tdspriet/qlock/stl/faceplate_BL.stl

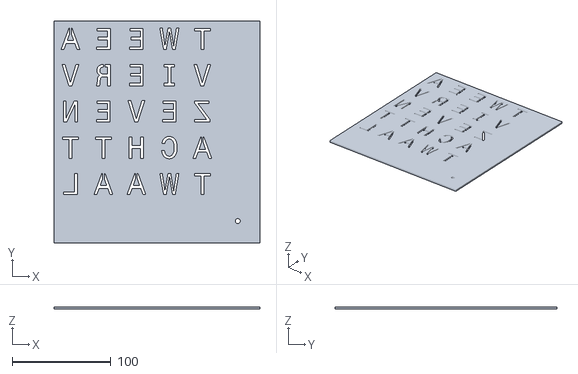
[picture p1: CAD file, 2026-11-09]
stl/faceplate_BL.stl
208.3 x 225.0 x 2.50
