tdspriet/qlock/stl/lightgrid_TR.stl

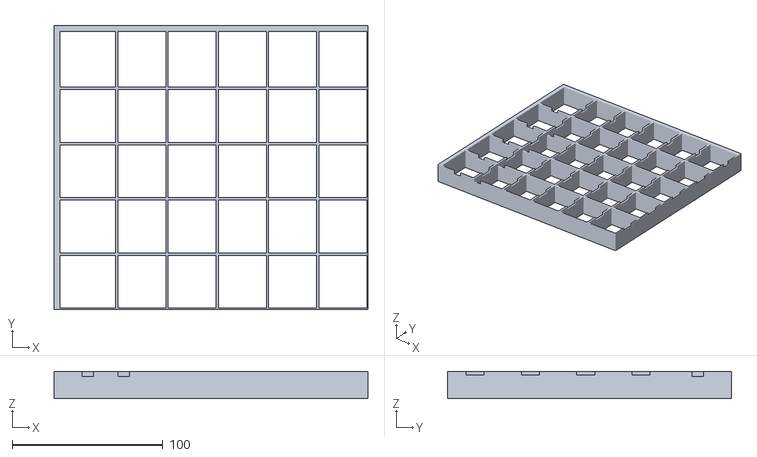
[picture p2: CAD file, 2026-11-09]
stl/lightgrid_TR.stl
208.3 x 188.3 x 18.0
