tdspriet/qlock/stl/faceplate_TR_letters.stl

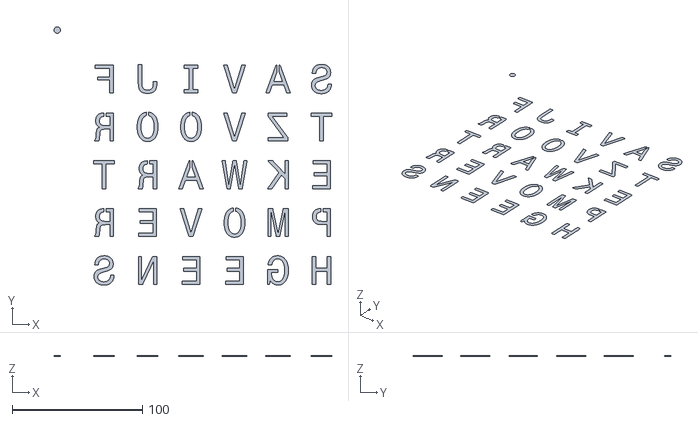
[picture p3: CAD file, 2026-11-09]
stl/faceplate_TR_letters.stl
213.1 x 198.1 x 0.4
