tdspriet/qlock/stl/faceplate_BR.stl

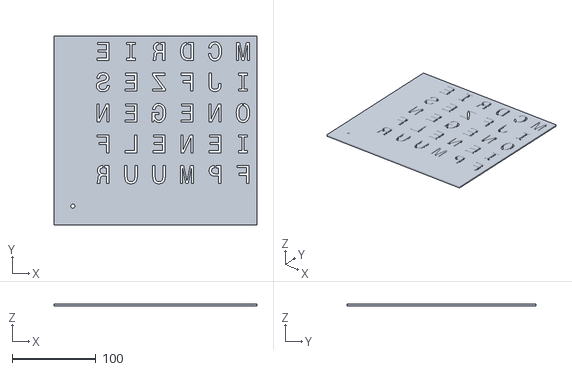
[picture p4: CAD file, 2026-11-09]
stl/faceplate_BR.stl
241.7 x 225.0 x 2.50
