tdspriet/qlock/stl/sample_faceplate_letters.stl

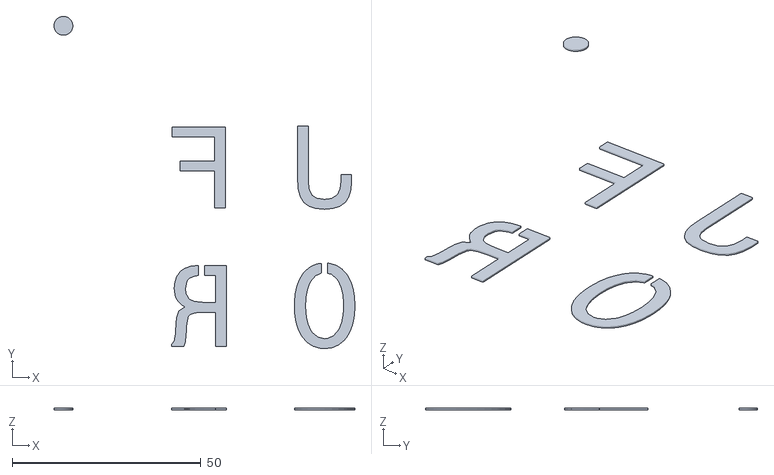
[picture p5: CAD file, 2026-11-09]
stl/sample_faceplate_letters.stl
79.8 x 88.1 x 0.4
