tdspriet/qlock/stl/lightgrid_BL.stl

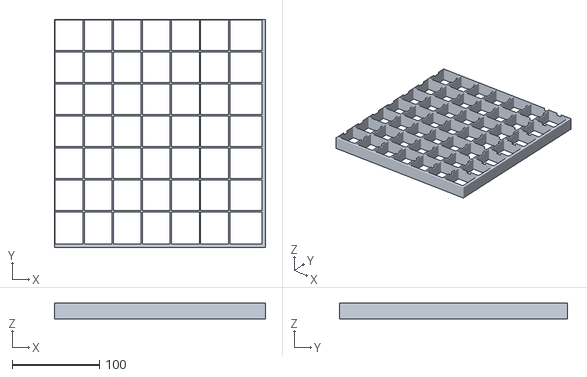
[picture p6: CAD file, 2026-11-09]
stl/lightgrid_BL.stl
241.7 x 261.7 x 18.0
