tdspriet/qlock/stl/lightgrid_TL.stl

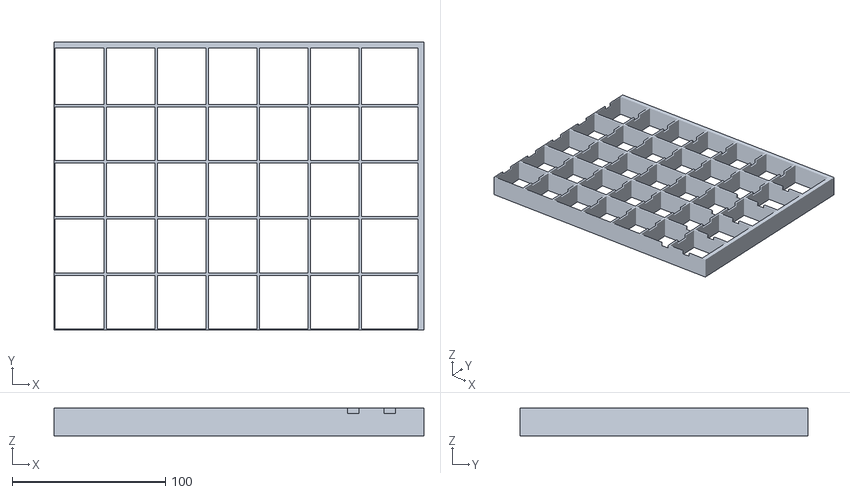
[picture p7: CAD file, 2026-11-09]
stl/lightgrid_TL.stl
241.7 x 188.3 x 18.0
