tdspriet/qlock/stl/faceplate_BL_letters.stl

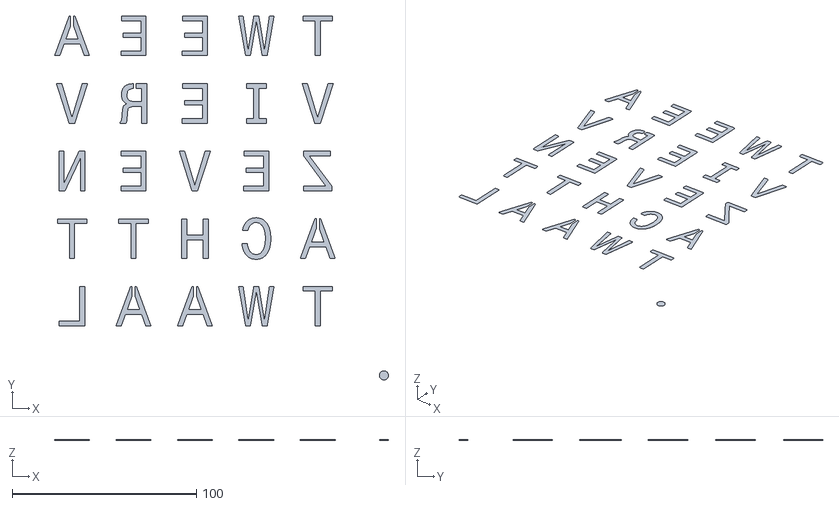
[picture p8: CAD file, 2026-11-09]
stl/faceplate_BL_letters.stl
181.3 x 197.5 x 0.4
