tdspriet/qlock/stl/faceplate_TL_letters.stl

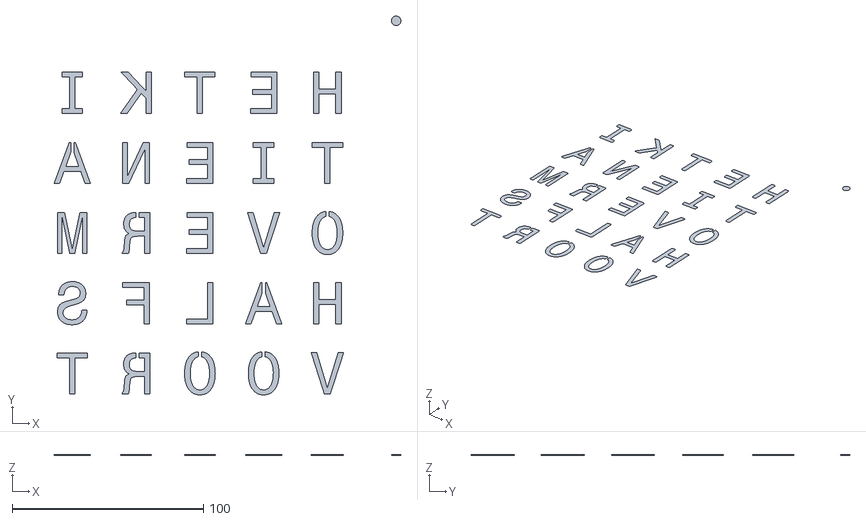
[picture p9: CAD file, 2026-11-09]
stl/faceplate_TL_letters.stl
181.3 x 198.0 x 0.4
