tdspriet/qlock/stl/sample_faceplate.stl

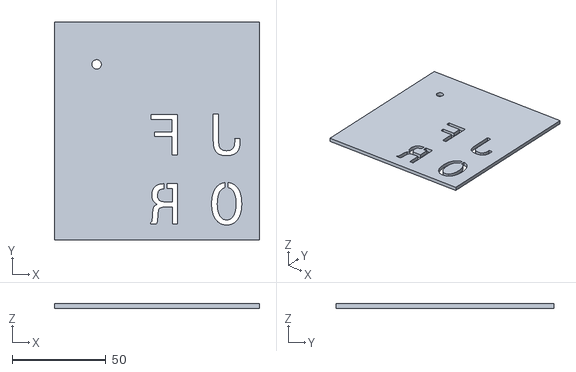
[picture p10: CAD file, 2026-11-09]
stl/sample_faceplate.stl
109.1 x 115.8 x 2.50
