tdspriet/qlock/stl/sample_lightgrid.stl

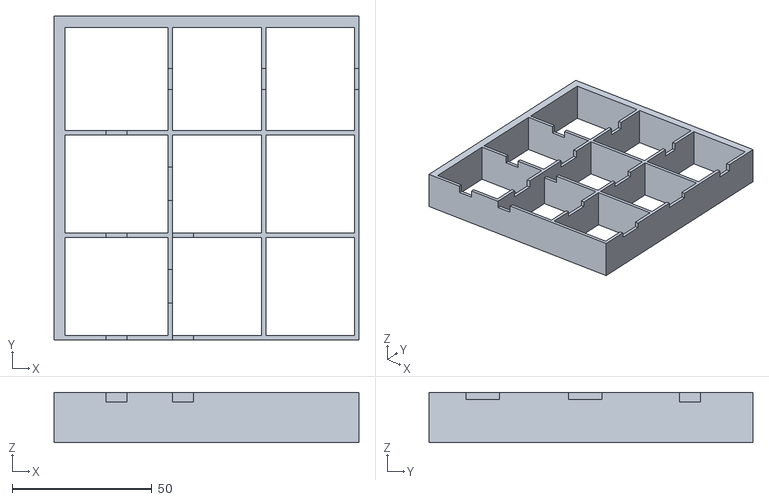
[picture p11: CAD file, 2026-11-09]
stl/sample_lightgrid.stl
109.1 x 115.8 x 18.0
