tdspriet/qlock/stl/lightgrid_BR.stl

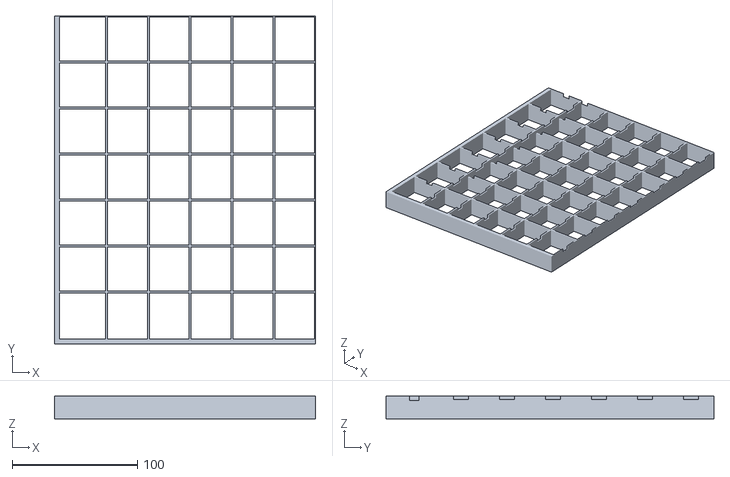
[picture p12: CAD file, 2026-11-09]
stl/lightgrid_BR.stl
208.3 x 261.7 x 18.0
