tdspriet/qlock/(list of files, cad)

Other CAD files:
stl/faceplate_TL.stl
stl/faceplate_TR.stl
stl/faceplate_BR_letters.stl
