tdspriet/qlock/(commit log)

2026-10-25 QLOCK: STLs, firmware, tools and build tracker
    [faceplate_BL.stl, faceplate_BR.stl, faceplate_TL.stl, faceplate_TR.stl, faceplate_sample.stl, lightgrid_BL.stl, lightgrid_BR.stl, lightgrid_TL.stl]
2026-10-25 Simplify the build tracker
    Cut what isn't needed day to day: stats header, up-next box, layer
    labels, camera presets, shop filters, paid field, build log and the
    rules tab. Calmer styling with one typeface and no stencil headings.
    Part card shows only the clicked part; light-up restores the exploded
    view; LED colour is the firmware's warm white in both themes.
    Claude-Session: https://claude.ai/code/session_01A9cgHg2mFhKhLrvVkcM7Kx
2026-11-09 Back to 45 × 45 cm, printed on the Bambu Lab H2C
    The 376 mm plate only existed to fit four tiles on the Ultimaker's 215 mm
    bed. On the H2C (325 × 320) the full 450 mm plate is still four tiles, the
    minimum, at most 241.7 × 225 mm each.
    - Same 30 LED/m column pitch; the extra size becomes a plain border, equal
    on all sides (rows now 36.667 mm apart).
    - Grid walls continue through the border to the rim as ribs.
    - Two more splines per seam, in the border: splines_x14, 12 needed.
    - verify.py checks the H2C bed instead of the UM3 Cura keep-outs.
    - README and build tracker: Bambu Studio settings, 1.75 mm PLA, new
    marking, film, frame and filament numbers.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
    [faceplate_BL.stl, faceplate_BR.stl, faceplate_TL.stl, faceplate_TR.stl, faceplate_sample.stl, lightgrid_BL.stl, lightgrid_BR.stl, lightgrid_TL.stl]
2026-11-09 Trim the project to a human size; white printed letters and minute dots
    Design
    - Letters are a 0.4 mm white skin printed into the black faceplate (two-colour
    on the H2C), replacing the diffuser film. Splines and their thin pockets are
    gone: faceplate and grid are split on different lines and glue to each other.
    - Four corner minute dots: 114 LEDs, a wire channel round the border.
    - Two-colour plates checked against the 300 x 320 mm area both nozzles reach.
    Folder
    - README.md is the one manual, in build order. The site is a short tick-off
    version of it: one page, no 3D viewer, no vendored libraries.
    - tools/make_stl.py generates and checks the print files in one run.
    - One LED test ske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
    [faceplate_BL.stl, faceplate_BL_letters.stl, faceplate_BR.stl, faceplate_BR_letters.stl, faceplate_TL.stl, faceplate_TL_letters.stl, faceplate_TR.stl, faceplate_TR_letters.stl]
2026-11-11 Match the guide to the parts that were ordered
    The ESP32 is now the ESP32-D0WDQ6 board (pins 5.0V, GND, GP16, no BOOT
    button), the LEDs are one 5 m reel from Amazon.de instead of five 1 m
    strips, and the 100 nF capacitor comes from Amazon.de too. The cutting
    steps take one row of 11 from each 15-LED section of the reel.
    Claude-Session: https://claude.ai/code/session_011F5DHiskQGePQL1KvLWZY3
2026-11-13 The printer is an H2D, not an H2C
    Same bed (325 × 320 per nozzle, 300 × 320 for both), so the parts don't
    change; only the name and the one-nozzle bed check.
